luis109/power_board/power_board.kicad_pcb

## KiCad design power_board.kicad_pcb (2021-07-13)

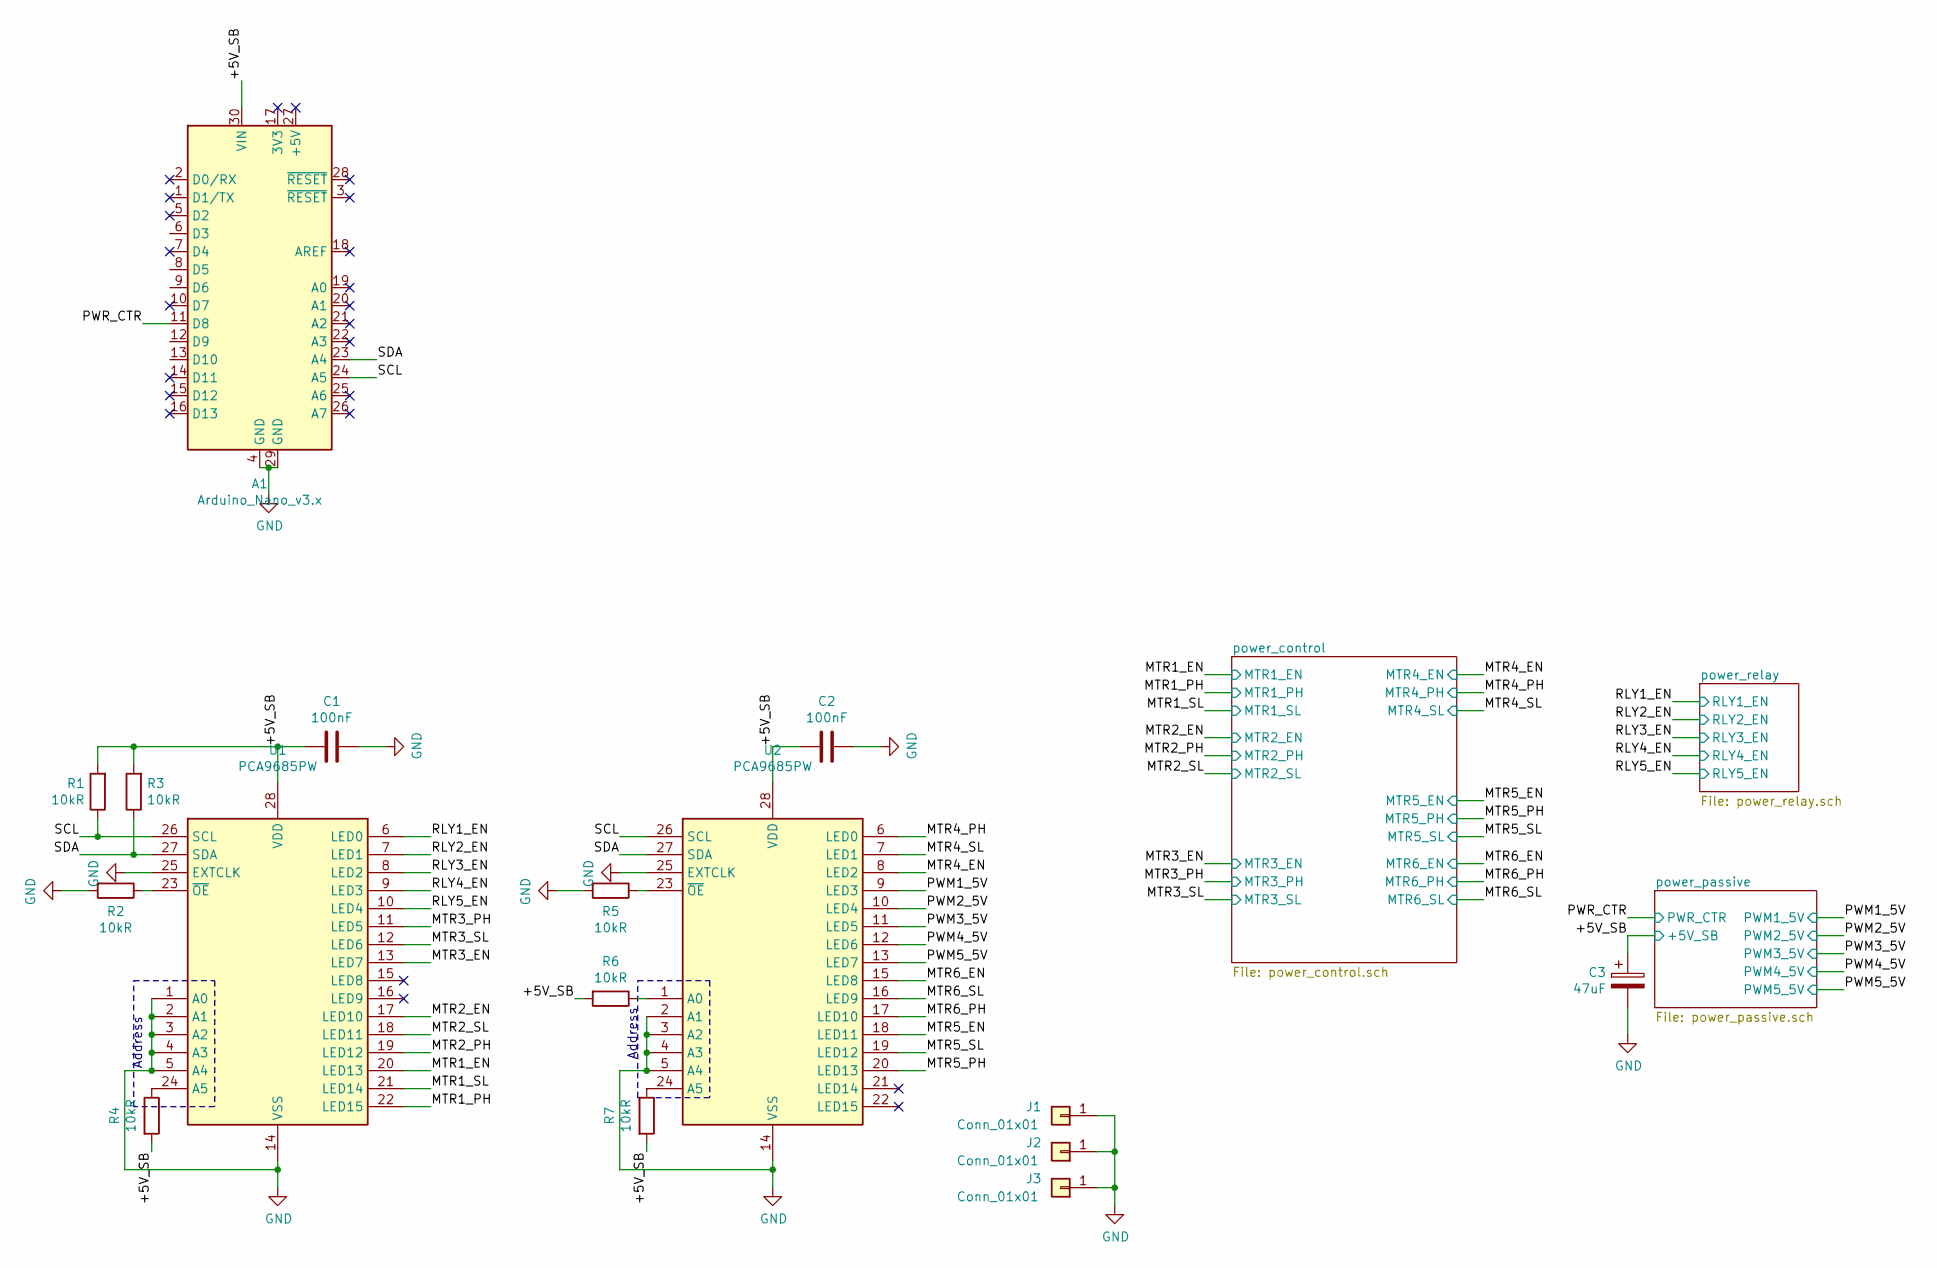
[picture p1: schematic power_board.sch]

Parts:
A1: Arduino_Nano_v3.x; Arduino_Nano
C1, C2: 100nF; C_0603
C3: 47uF; CP_Radial_D5.0mm_P2.00mm
J1, J2, J3: Conn_01x01; MountingHole_3.5mm_Pad
R1, R2, R3, R4, R5, R6, R7: 10kR; R_0603
U1, U2: PCA9685PW; TSSOP-28_4.4x9.7mm_P0.65mm

Connections:
/+5V_SB: A1.30 (VIN), C1.2, C2.2, C3.1, R1.2, R3.2, R4.2, R6.2, R7.2, U1.28 (VDD), U2.28 (VDD); also elsewhere on the board
/MTR1_EN: U1.20 (LED13); also elsewhere on the board
/MTR1_PH: U1.22 (LED15); also elsewhere on the board
/MTR1_SL: U1.21 (LED14); also elsewhere on the board
/MTR2_EN: U1.17 (LED10); also elsewhere on the board
/MTR2_PH: U1.19 (LED12); also elsewhere on the board
/MTR2_SL: U1.18 (LED11); also elsewhere on the board
/MTR3_EN: U1.13 (LED7); also elsewhere on the board
/MTR3_PH: U1.11 (LED5); also elsewhere on the board
/MTR3_SL: U1.12 (LED6); also elsewhere on the board
/MTR4_EN: U2.8 (LED2); also elsewhere on the board
/MTR4_PH: U2.6 (LED0); also elsewhere on the board
/MTR4_SL: U2.7 (LED1); also elsewhere on the board
/MTR5_EN: U2.18 (LED11); also elsewhere on the board
/MTR5_PH: U2.20 (LED13); also elsewhere on the board
/MTR5_SL: U2.19 (LED12); also elsewhere on the board
/MTR6_EN: U2.15 (LED8); also elsewhere on the board
/MTR6_PH: U2.17 (LED10); also elsewhere on the board
/MTR6_SL: U2.16 (LED9); also elsewhere on the board
/PWM1_5V: U2.9 (LED3); also elsewhere on the board
/PWM2_5V: U2.10 (LED4); also elsewhere on the board
/PWM3_5V: U2.11 (LED5); also elsewhere on the board
/PWM4_5V: U2.12 (LED6); also elsewhere on the board
/PWM5_5V: U2.13 (LED7); also elsewhere on the board
/PWR_CTR: A1.11 (D8); also elsewhere on the board
/RLY1_EN: U1.6 (LED0); also elsewhere on the board
/RLY2_EN: U1.7 (LED1); also elsewhere on the board
/RLY3_EN: U1.8 (LED2); also elsewhere on the board
/RLY4_EN: U1.9 (LED3); also elsewhere on the board
/RLY5_EN: U1.10 (LED4); also elsewhere on the board
/SCL: A1.24 (A5), R1.1, U1.26 (SCL), U2.26 (SCL)
/SDA: A1.23 (A4), R3.1, U1.27 (SDA), U2.27 (SDA)
GND: A1.4 (GND), A1.29 (GND), C1.1, C2.1, C3.2, J1.1, J2.1, J3.1, R2.2, R5.2, U1.1 (A0), U1.2 (A1), U1.3 (A2), U1.4 (A3), U1.5 (A4), U1.14 (VSS), U1.25 (EXTCLK), U2.2 (A1), U2.3 (A2), U2.4 (A3), U2.5 (A4), U2.14 (VSS), U2.25 (EXTCLK); also elsewhere on the board
unnamed: R2.1, U1.23 (~OE)
unnamed: R4.1, U1.24 (A5)
unnamed: R5.1, U2.23 (~OE)
unnamed: R6.1, U2.1 (A0)
unnamed: R7.1, U2.24 (A5)

Notes on the sheet:
Address

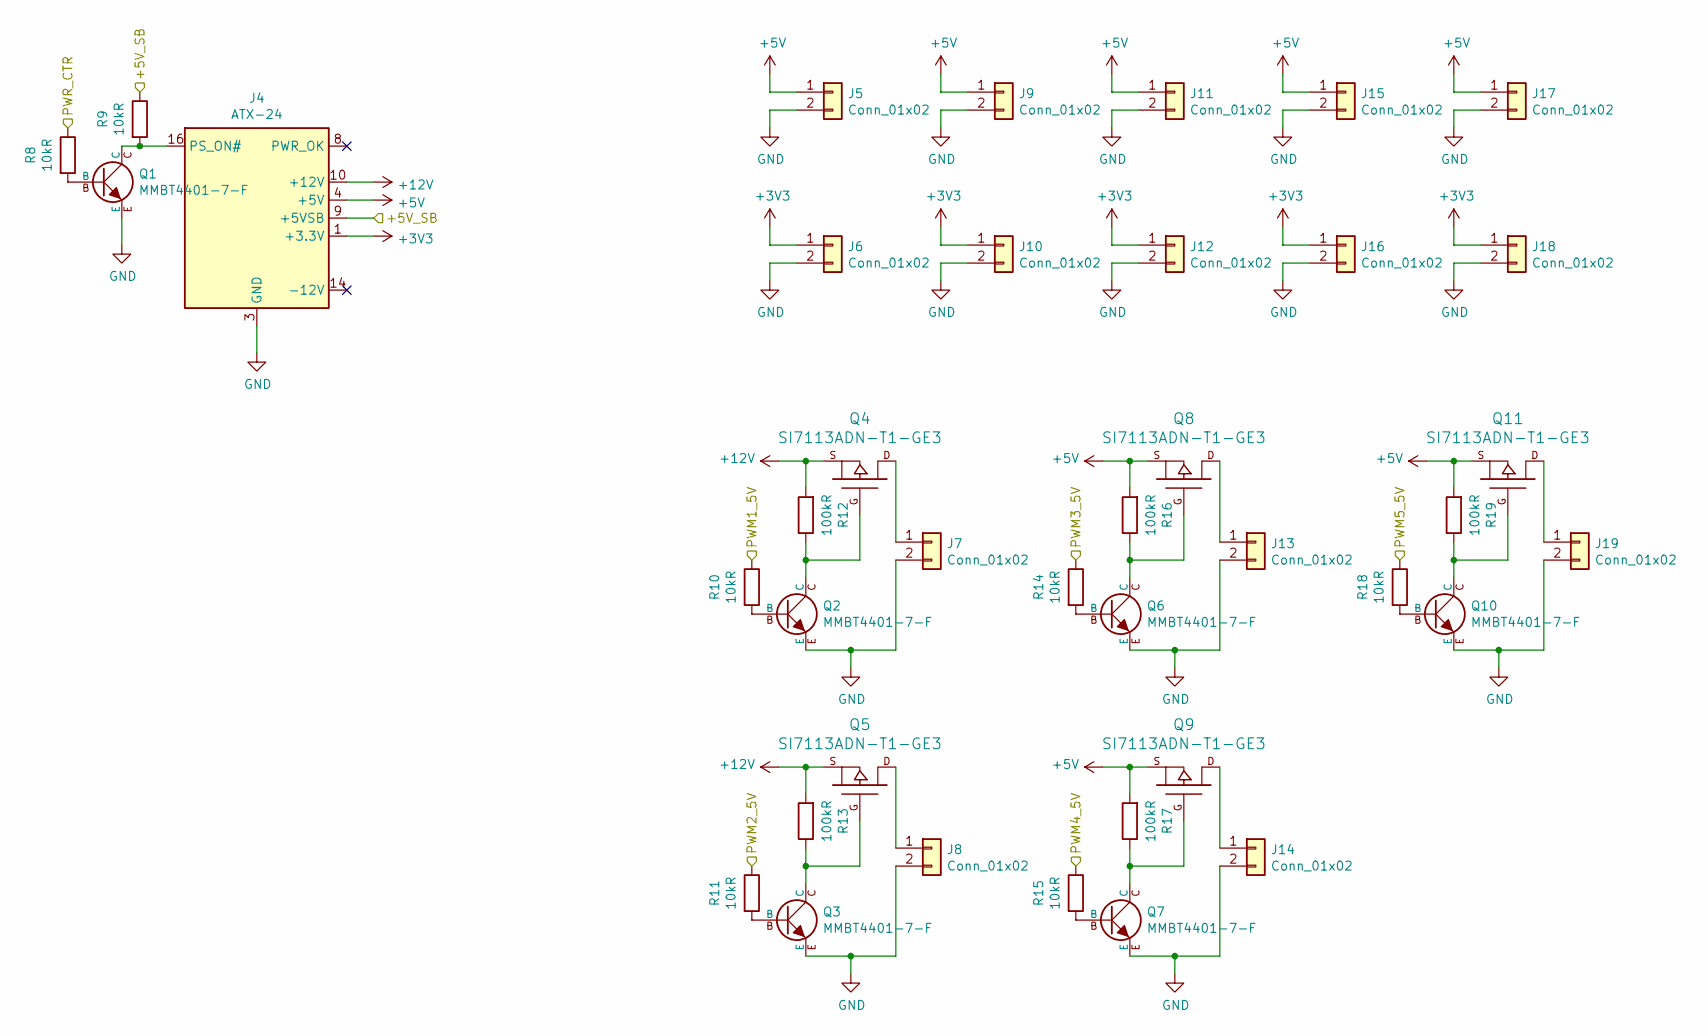
[picture p2: schematic power_passive.sch]

Parts:
J4: ATX-24; Molex_Mini-Fit_Jr_5566-24A_2x12_P4.20mm_Vertical
J5, J6, J7, J8, J9, J10, J11, J12, J13, J14, J15, J16, J17, J18, J19: Conn_01x02; Molex_Micro-Fit_3.0_43045-0212_2x01_P3.00mm_Vertical
Q1, Q2, Q3, Q6, Q7, Q10: MMBT4401-7-F; SOT23_BC817
Q4, Q5, Q8, Q9, Q11: SI7113ADN-T1-GE3; PowerPAK_1212-8
R8, R9, R10, R11, R14, R15, R18: 10kR; R_0603
R12, R13, R16, R17, R19: 100kR; R_0603

Connections:
+3V3: J4.1 (+3.3V), J4.2 (+3.3V), J4.12 (+3.3V), J4.13 (+3.3V), J6.1, J10.1, J12.1, J16.1, J18.1
+5V: J4.4 (+5V), J4.6 (+5V), J4.21 (+5V), J4.22 (+5V), J4.23 (+5V), J5.1, J9.1, J11.1, J15.1, J17.1, Q8.S, Q9.S, Q11.S, R16.2, R17.2, R19.2; also elsewhere on the board
+12V: J4.10 (+12V), J4.11 (+12V), Q4.S, Q5.S, R12.2, R13.2; also elsewhere on the board
/+5V_SB: J4.9 (+5VSB), R9.1; also elsewhere on the board
/PWM1_5V: R10.1; also elsewhere on the board
/PWM2_5V: R11.1; also elsewhere on the board
/PWM3_5V: R14.1; also elsewhere on the board
/PWM4_5V: R15.1; also elsewhere on the board
/PWM5_5V: R18.1; also elsewhere on the board
/PWR_CTR: R8.1; also elsewhere on the board
GND: J4.3 (GND), J4.5 (GND), J4.7 (GND), J4.15 (GND), J4.17 (GND), J4.18 (GND), J4.19 (GND), J4.24 (GND), J5.2, J6.2, J7.2, J8.2, J9.2, J10.2, J11.2, J12.2, J13.2, J14.2, J15.2, J16.2, J17.2, J18.2, J19.2, Q1.E, Q2.E, Q3.E, Q6.E, Q7.E, Q10.E; also elsewhere on the board
unnamed: J4.16 (PS_ON#), Q1.C, R9.2
unnamed: J7.1, Q4.D
unnamed: J8.1, Q5.D
unnamed: J13.1, Q8.D
unnamed: J14.1, Q9.D
unnamed: J19.1, Q11.D
unnamed: Q1.B, R8.2
unnamed: Q2.B, R10.2
unnamed: Q2.C, Q4.G, R12.1
unnamed: Q3.B, R11.2
unnamed: Q3.C, Q5.G, R13.1
unnamed: Q6.B, R14.2
unnamed: Q6.C, Q8.G, R16.1
unnamed: Q7.B, R15.2
unnamed: Q7.C, Q9.G, R17.1
unnamed: Q10.B, R18.2
unnamed: Q10.C, Q11.G, R19.1

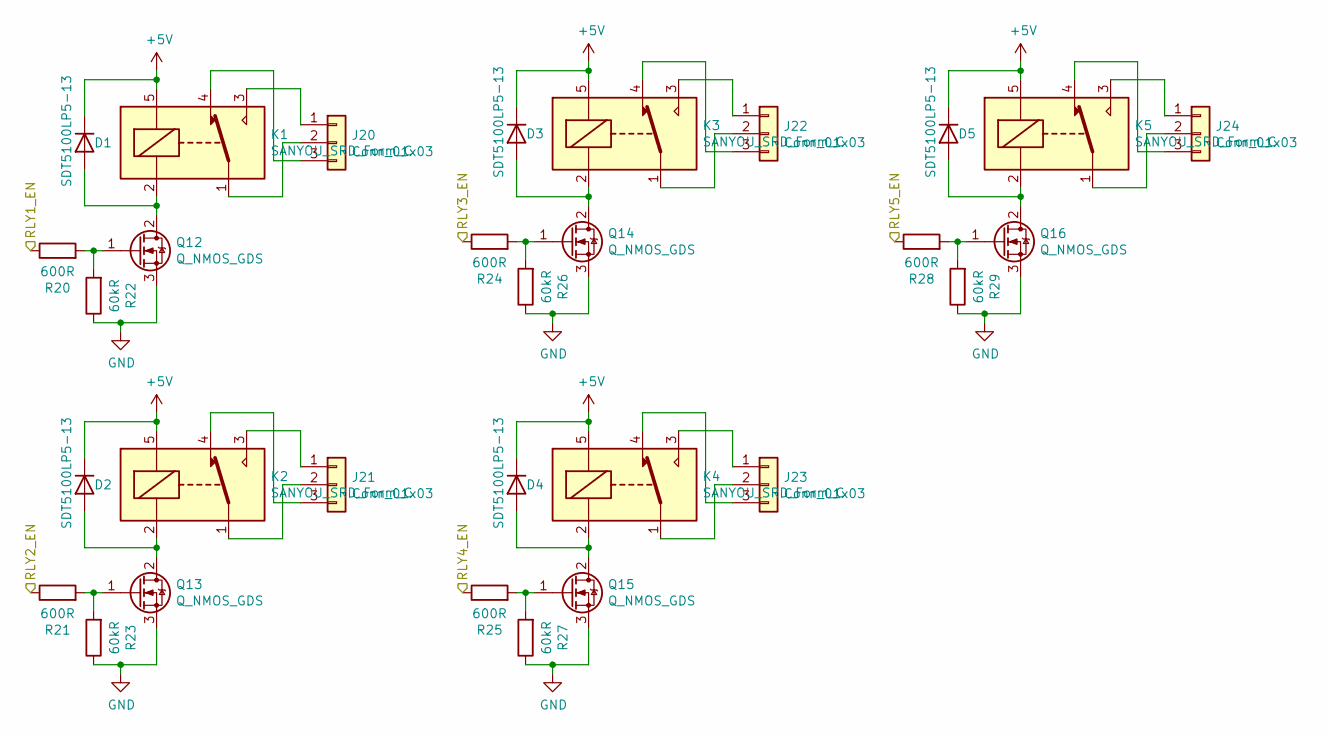
[picture p3: schematic power_relay.sch]

Parts:
D1, D2, D3, D4, D5: SDT5100LP5-13; D_PowerDI-5
J20, J21, J22, J23, J24: Conn_01x03; TerminalBlock_Phoenix_PT-1,5-3-3.5-H_1x03_P3.50mm_Horizontal
K1, K2, K3, K4, K5: SANYOU_SRD_Form_C; Relay_SPDT_SANYOU_SRD_Series_Form_C
Q12, Q13, Q14, Q15, Q16: Q_NMOS_GDS; TO-252-2
R20, R21, R24, R25, R28: 600R; R_0603
R22, R23, R26, R27, R29: 60kR; R_0603

Connections:
+5V: D1.1 (K), D2.1 (K), D3.1 (K), D4.1 (K), D5.1 (K), K1.5, K2.5, K3.5, K4.5, K5.5; also elsewhere on the board
/RLY1_EN: R20.1; also elsewhere on the board
/RLY2_EN: R21.1; also elsewhere on the board
/RLY3_EN: R24.1; also elsewhere on the board
/RLY4_EN: R25.1; also elsewhere on the board
/RLY5_EN: R28.1; also elsewhere on the board
GND: Q12.3 (S), Q13.3 (S), Q14.3 (S), Q15.3 (S), Q16.3 (S), R22.1, R23.1, R26.1, R27.1, R29.1; also elsewhere on the board
unnamed: D1.2 (A), K1.2, Q12.2 (D)
unnamed: D2.2 (A), K2.2, Q13.2 (D)
unnamed: D3.2 (A), K3.2, Q14.2 (D)
unnamed: D4.2 (A), K4.2, Q15.2 (D)
unnamed: D5.2 (A), K5.2, Q16.2 (D)
unnamed: J20.1, K1.3
unnamed: J20.2, K1.1
unnamed: J20.3, K1.4
unnamed: J21.1, K2.3
unnamed: J21.2, K2.1
unnamed: J21.3, K2.4
unnamed: J22.1, K3.3
unnamed: J22.2, K3.1
unnamed: J22.3, K3.4
unnamed: J23.1, K4.3
unnamed: J23.2, K4.1
unnamed: J23.3, K4.4
unnamed: J24.1, K5.3
unnamed: J24.2, K5.1
unnamed: J24.3, K5.4
unnamed: Q12.1 (G), R20.2, R22.2
unnamed: Q13.1 (G), R21.2, R23.2
unnamed: Q14.1 (G), R24.2, R26.2
unnamed: Q15.1 (G), R25.2, R27.2
unnamed: Q16.1 (G), R28.2, R29.2

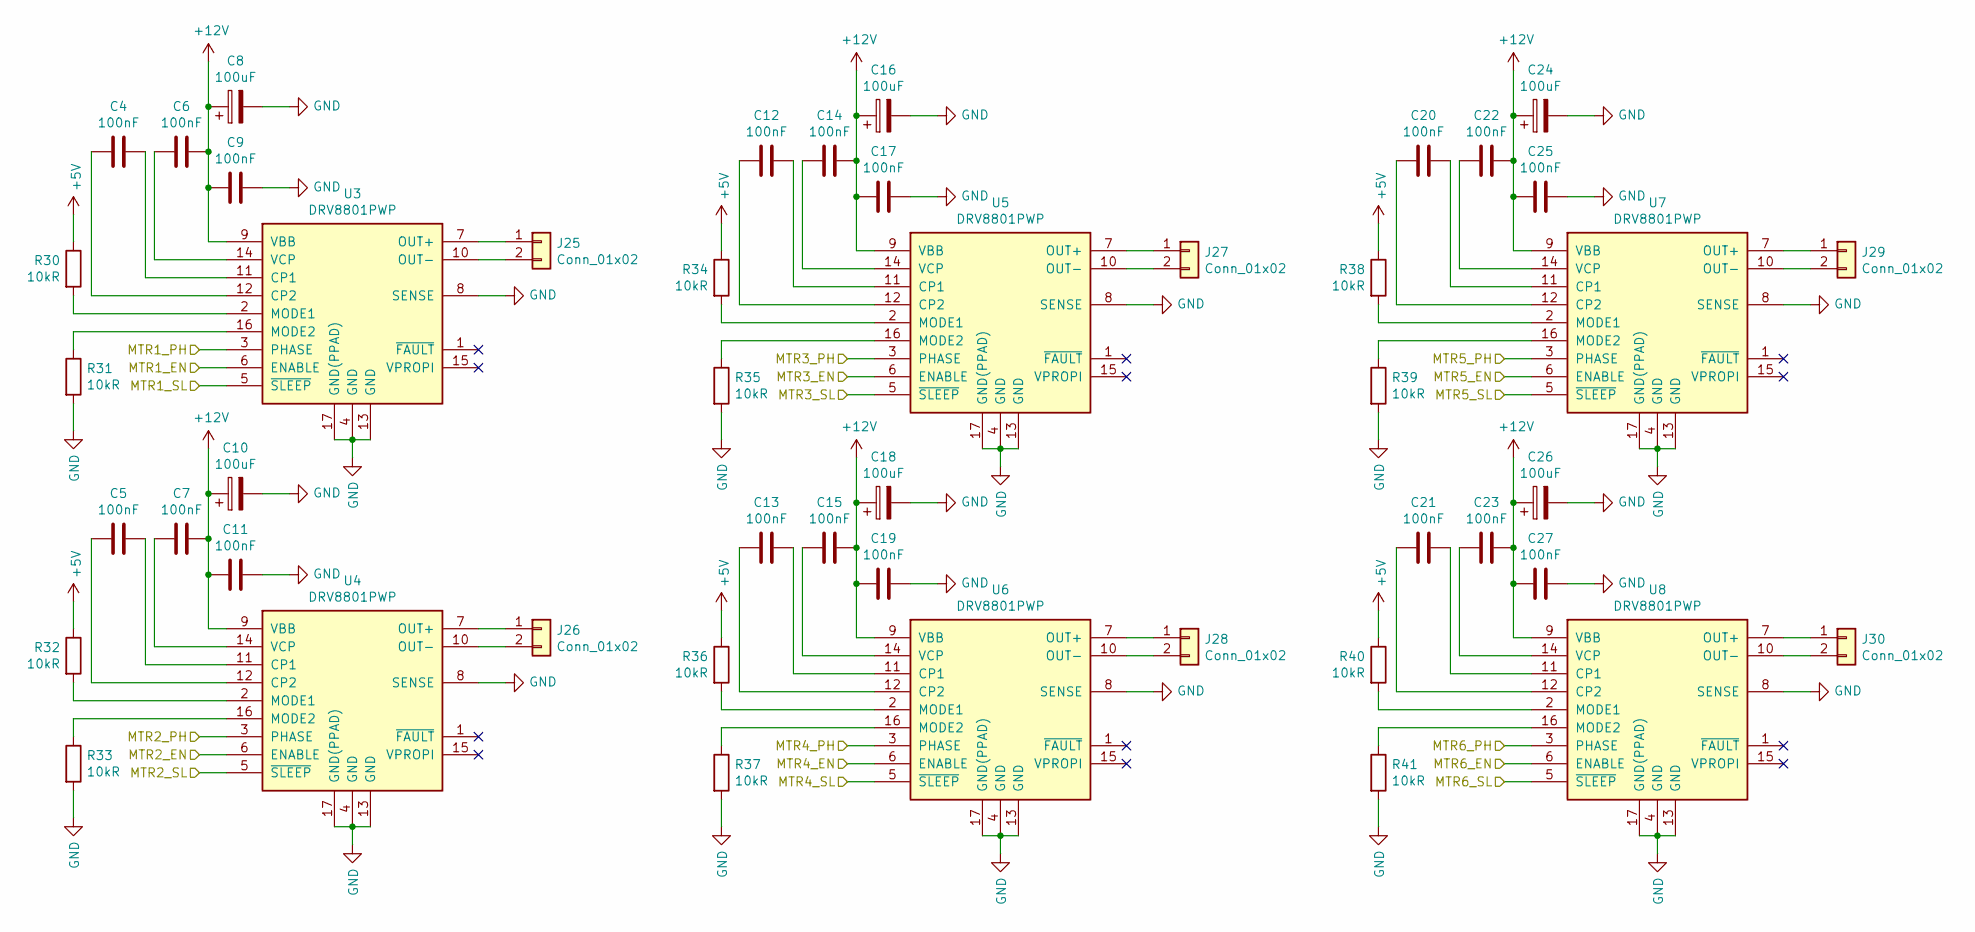
[picture p4: schematic power_control.sch]

Parts:
C4, C5, C6, C7, C9, C11, C12, C13, C14, C15, C17, C19, C20, C21, C22, C23, C25, C27: 100nF; C_0603
C8, C10, C16, C18, C24, C26: 100uF; CP_Radial_D5.0mm_P2.00mm
J25, J26, J27, J28, J29, J30: Conn_01x02; Molex_Micro-Fit_3.0_43045-0212_2x01_P3.00mm_Vertical
R30, R31, R32, R33, R34, R35, R36, R37, R38, R39, R40, R41: 10kR; R_0603
U3, U4, U5, U6, U7, U8: DRV8801PWP; HTSSOP-16-1EP_4.4x5mm_P0.65mm_EP3.4x5mm_Mask3x3mm_ThermalVi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

Connections:
+5V: R30.1, R32.1, R34.1, R36.1, R38.1, R40.1; also elsewhere on the board
+12V: C6.1, C7.1, C8.1, C9.2, C10.1, C11.2, C14.1, C15.1, C16.1, C17.2, C18.1, C19.2, C22.1, C23.1, C24.1, C25.2, C26.1, C27.2, U3.9 (VBB), U4.9 (VBB), U5.9 (VBB), U6.9 (VBB), U7.9 (VBB), U8.9 (VBB); also elsewhere on the board
/MTR1_EN: U3.6 (ENABLE); also elsewhere on the board
/MTR1_PH: U3.3 (PHASE); also elsewhere on the board
/MTR1_SL: U3.5 (~SLEEP); also elsewhere on the board
/MTR2_EN: U4.6 (ENABLE); also elsewhere on the board
/MTR2_PH: U4.3 (PHASE); also elsewhere on the board
/MTR2_SL: U4.5 (~SLEEP); also elsewhere on the board
/MTR3_EN: U5.6 (ENABLE); also elsewhere on the board
/MTR3_PH: U5.3 (PHASE); also elsewhere on the board
/MTR3_SL: U5.5 (~SLEEP); also elsewhere on the board
/MTR4_EN: U6.6 (ENABLE); also elsewhere on the board
/MTR4_PH: U6.3 (PHASE); also elsewhere on the board
/MTR4_SL: U6.5 (~SLEEP); also elsewhere on the board
/MTR5_EN: U7.6 (ENABLE); also elsewhere on the board
/MTR5_PH: U7.3 (PHASE); also elsewhere on the board
/MTR5_SL: U7.5 (~SLEEP); also elsewhere on the board
/MTR6_EN: U8.6 (ENABLE); also elsewhere on the board
/MTR6_PH: U8.3 (PHASE); also elsewhere on the board
/MTR6_SL: U8.5 (~SLEEP); also elsewhere on the board
GND: C8.2, C9.1, C10.2, C11.1, C16.2, C17.1, C18.2, C19.1, C24.2, C25.1, C26.2, C27.1, R31.2, R33.2, R35.2, R37.2, R39.2, R41.2, U3.4 (GND), U3.8 (SENSE), U3.13 (GND), U3.17 (GND(PPAD)), U4.4 (GND), U4.8 (SENSE), U4.13 (GND), U4.17 (GND(PPAD)), U5.4 (GND), U5.8 (SENSE), U5.13 (GND), U5.17 (GND(PPAD)), U6.4 (GND), U6.8 (SENSE), U6.13 (GND), U6.17 (GND(PPAD)), U7.4 (GND), U7.8 (SENSE), U7.13 (GND), U7.17 (GND(PPAD)), U8.4 (GND), U8.8 (SENSE), U8.13 (GND), U8.17 (GND(PPAD)); also elsewhere on the board
unnamed: C4.1, U3.11 (CP1)
unnamed: C4.2, U3.12 (CP2)
unnamed: C5.1, U4.11 (CP1)
unnamed: C5.2, U4.12 (CP2)
unnamed: C6.2, U3.14 (VCP)
unnamed: C7.2, U4.14 (VCP)
unnamed: C12.1, U5.11 (CP1)
unnamed: C12.2, U5.12 (CP2)
unnamed: C13.1, U6.11 (CP1)
unnamed: C13.2, U6.12 (CP2)
unnamed: C14.2, U5.14 (VCP)
unnamed: C15.2, U6.14 (VCP)
unnamed: C20.1, U7.11 (CP1)
unnamed: C20.2, U7.12 (CP2)
unnamed: C21.1, U8.11 (CP1)
unnamed: C21.2, U8.12 (CP2)
unnamed: C22.2, U7.14 (VCP)
unnamed: C23.2, U8.14 (VCP)
unnamed: J25.1, U3.7 (OUT+)
unnamed: J25.2, U3.10 (OUT-)
unnamed: J26.1, U4.7 (OUT+)
unnamed: J26.2, U4.10 (OUT-)
unnamed: J27.1, U5.7 (OUT+)
unnamed: J27.2, U5.10 (OUT-)
unnamed: J28.1, U6.7 (OUT+)
unnamed: J28.2, U6.10 (OUT-)
unnamed: J29.1, U7.7 (OUT+)
unnamed: J29.2, U7.10 (OUT-)
unnamed: J30.1, U8.7 (OUT+)
unnamed: J30.2, U8.10 (OUT-)
unnamed: R30.2, U3.2 (MODE1)
unnamed: R31.1, U3.16 (MODE2)
unnamed: R32.2, U4.2 (MODE1)
unnamed: R33.1, U4.16 (MODE2)
unnamed: R34.2, U5.2 (MODE1)
unnamed: R35.1, U5.16 (MODE2)
unnamed: R36.2, U6.2 (MODE1)
unnamed: R37.1, U6.16 (MODE2)
unnamed: R38.2, U7.2 (MODE1)
unnamed: R39.1, U7.16 (MODE2)
unnamed: R40.2, U8.2 (MODE1)
unnamed: R41.1, U8.16 (MODE2)

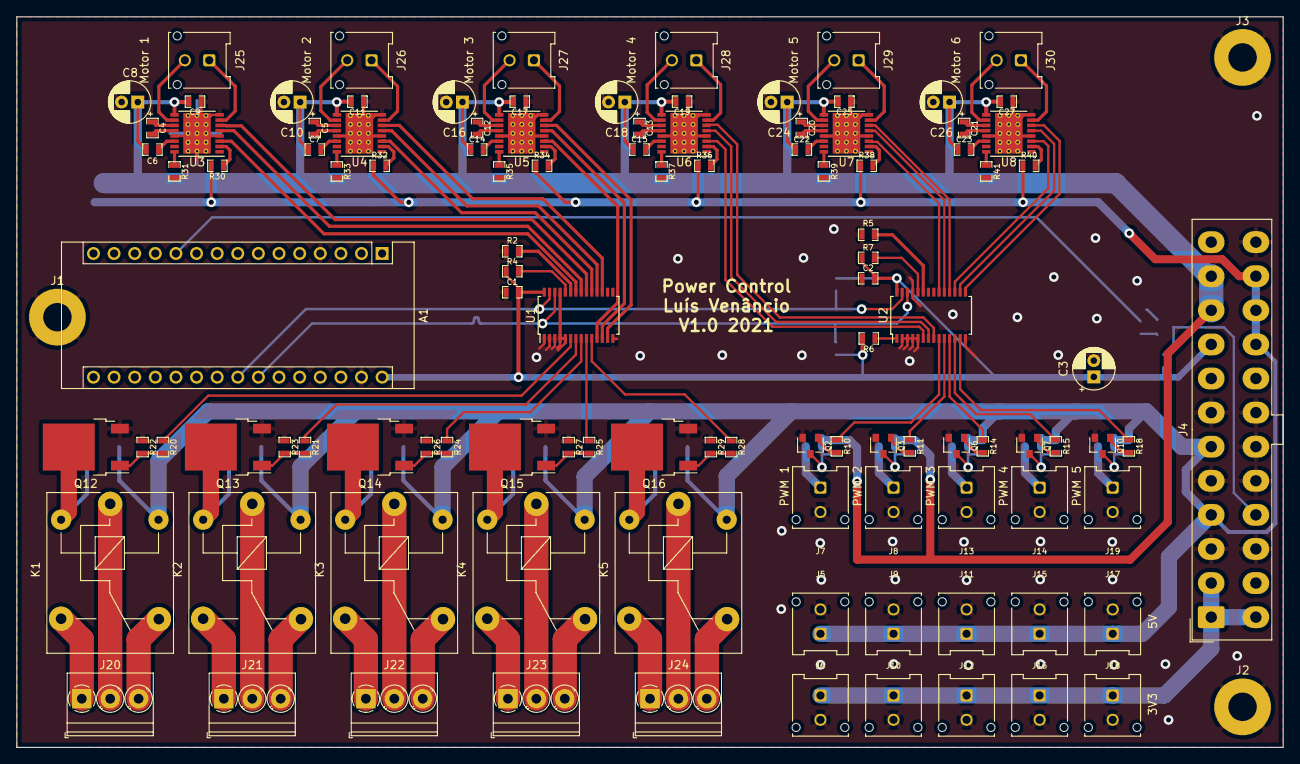
[picture p5: board power_board.kicad_pcb from above]

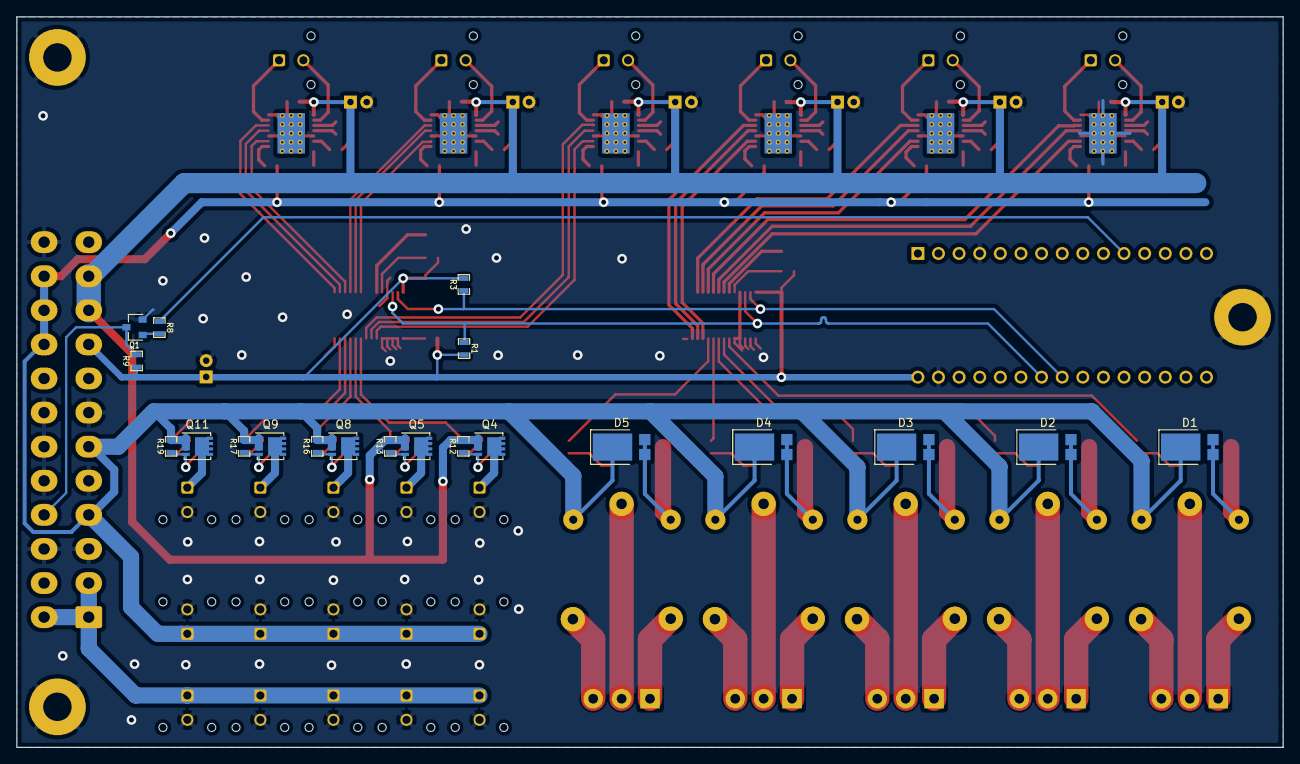
[picture p6: board power_board.kicad_pcb from below]

Board: 2 copper layers, 156.0 x 90.0 mm, 133 parts (20 on the bottom side), 125 nets.
