luis109/power_board/(commit log)

2020-01-17 Motor control positioning
    [power_board.kicad_pcb, power_board.sch, power_control.sch]
2020-01-20 Motor control finished
    [power_board.kicad_pcb, power_board.sch]
2020-01-20 PWM entries positioning
    [power_board.kicad_pcb]
2020-01-20 Power wiring finished
    [power_board.kicad_pcb]
2020-01-20 Initial attempt
    [power_board.kicad_pcb]
2020-01-22 All blocks aligned
    [power_board.kicad_pcb, power_control.sch]
2020-01-22 Positioning finished
    Lacks fine alignment.
    [power_board.kicad_pcb, power_board.sch, power_control.sch, power_passive.sch, power_relay.sch]
2020-01-22 Start MCU layout
    [power_board.kicad_pcb, power_board.sch, power_control.sch, power_passive.sch, power_relay.sch]
2020-01-23 Fine tune position. Power lines mtr and passive.
    [power_board.kicad_pcb]
2020-01-23 Initial MCU positioning. Reassign LED.
    [power_board.kicad_pcb, power_board.sch]
2020-01-23 ATX to right side
    [power_board.kicad_pcb]
2020-01-27 ICs positioning
    [power_board.kicad_pcb, power_board.sch, power_passive.sch]
2020-01-27 I2C lines positioned and tunned
    [power_board.kicad_pcb]
2020-01-27 All components placed.
    [power_board.kicad_pcb]
2020-01-27 Zones filled
    [power_board.kicad_pcb]
2020-01-28 All connections complete
    [power_board.kicad_pcb]
2020-01-29 Silkscreen done
    [power_board.kicad_pcb]
2020-01-30 Added 47uF electrolytic capacitor to 5V_SB.
    [power_board.kicad_pcb, power_board.sch]
2020-01-31 Added capacitor references
    [power_board.kicad_pcb, power_board.sch, power_control.sch]
2020-02-04 Added remaining 0603 references
    [power_board.kicad_pcb, power_board.sch, power_control.sch, power_passive.sch, power_relay.sch]
2020-02-05 Changed "out of stock" references.
    [power_board.sch, power_control.sch, power_relay.sch]
2020-02-28 Removed L6203
    [power_board.kicad_pcb, power_board.sch, power_control.sch]
2020-03-02 Added DRV8801PWP to schematic
    [power_board.kicad_pcb, power_board.sch, power_control.sch]
2020-03-02 Footprint configuration
    [power_board.kicad_pcb]
2020-03-03 Initial board placement.
    [power_board.kicad_pcb]
2020-03-03 Replaced FTDI placement.
    [power_board.kicad_pcb, power_board.sch]
2020-03-05 New driver arrangement
    [power_board.kicad_pcb, power_board.sch]
2020-03-07 Driver control routed
    [power_board.kicad_pcb]
2020-03-07 Finished connections
    [power_board.kicad_pcb]
2020-03-10 Finished silkscreen.
    [power_board.kicad_pcb]
2020-03-21 Small changes and added labels
    [power_board.kicad_pcb, power_relay.sch]
2020-03-22 Removed PCA9555 and added PCA9685
    [power_board.kicad_pcb, power_board.sch]
2020-03-22 Increased motor connectors distance to board edge
    [power_board.kicad_pcb]
2020-03-22 Reroute ISP
    [power_board.kicad_pcb]
2020-04-05 Changed ATX-24 symbol to merged version.
    [power_board.kicad_pcb, power_passive.sch]
2020-05-27 Switch PMW 1 & 2 to 12V
    [power_board.kicad_pcb, power_passive.sch]
2021-06-03 Replaced MCU by Arduino Nano
    [power_board.kicad_pcb, power_board.sch, power_passive.sch]
2021-07-13 Final touches
    [power_board.csv, power_board.kicad_pcb, power_board.sch, power_control.sch, power_passive.sch, power_relay.sch]
